fjpolo/UBC41ClassATubeAudioAmplifier/02 Imagenes/862703_4882853162860_1703502608_n.jpg

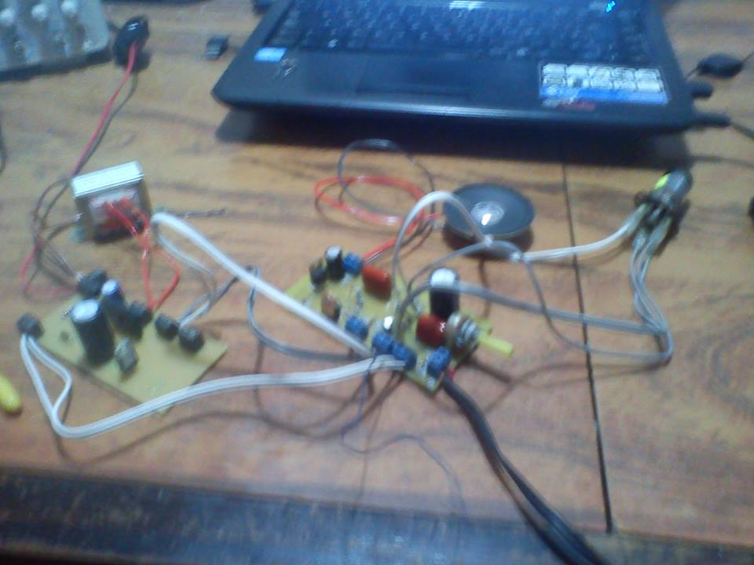
02 Imagenes/862703_4882853162860_1703502608_n.jpg
