fjpolo/UBC41ClassATubeAudioAmplifier/02 Imagenes/007 PCB.JPG

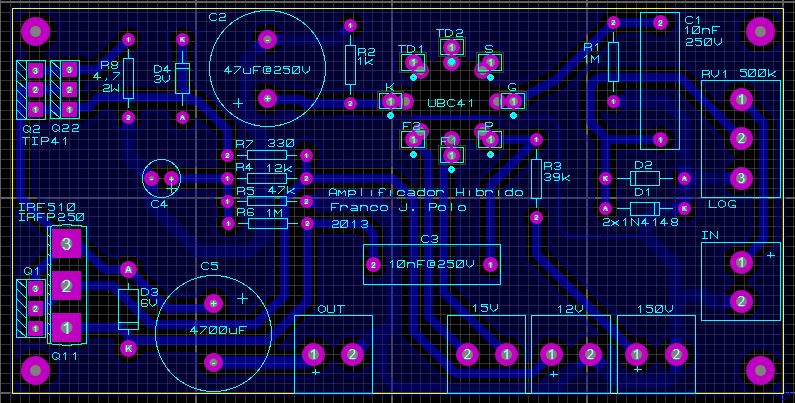
02 Imagenes/007 PCB.JPG
