fjpolo/UBC41ClassATubeAudioAmplifier/README.md

# UBC41ClassATubeAudioAmplifier
A hybrid Class A audio amplifier using an old RF UBC41.
