fjpolo/UBC41ClassATubeAudioAmplifier/005 PCB/Final.docx

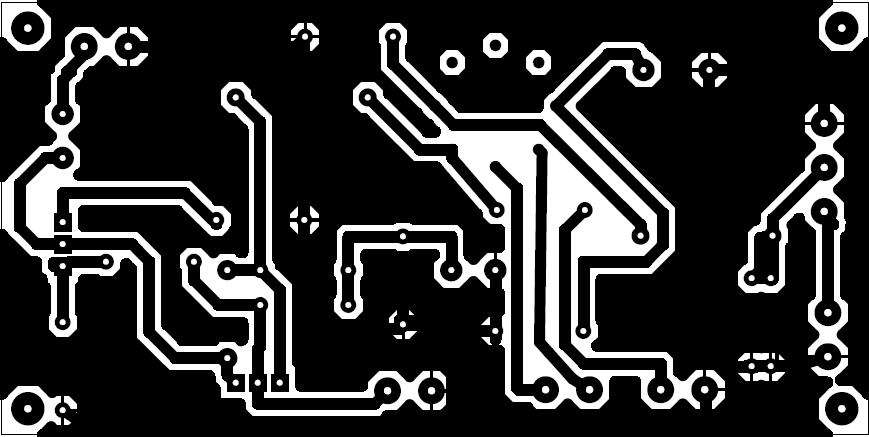
[picture p43: figure]
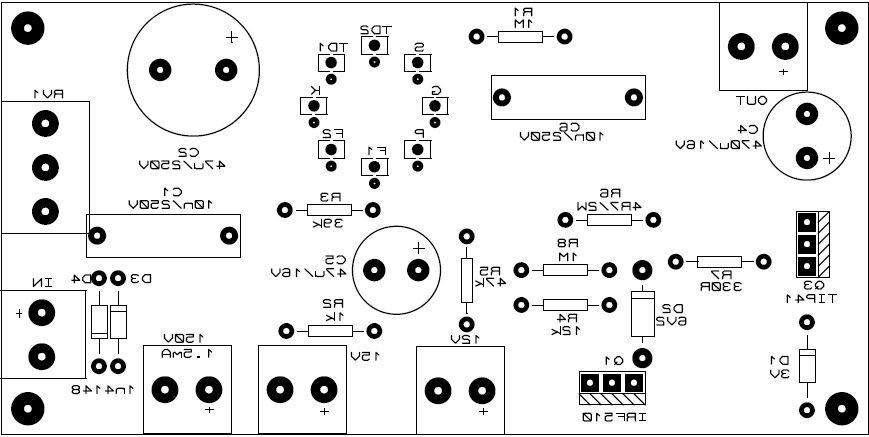
[picture p44: figure]
