fjpolo/UBC41ClassATubeAudioAmplifier/02 Imagenes/001 Schematic.JPG

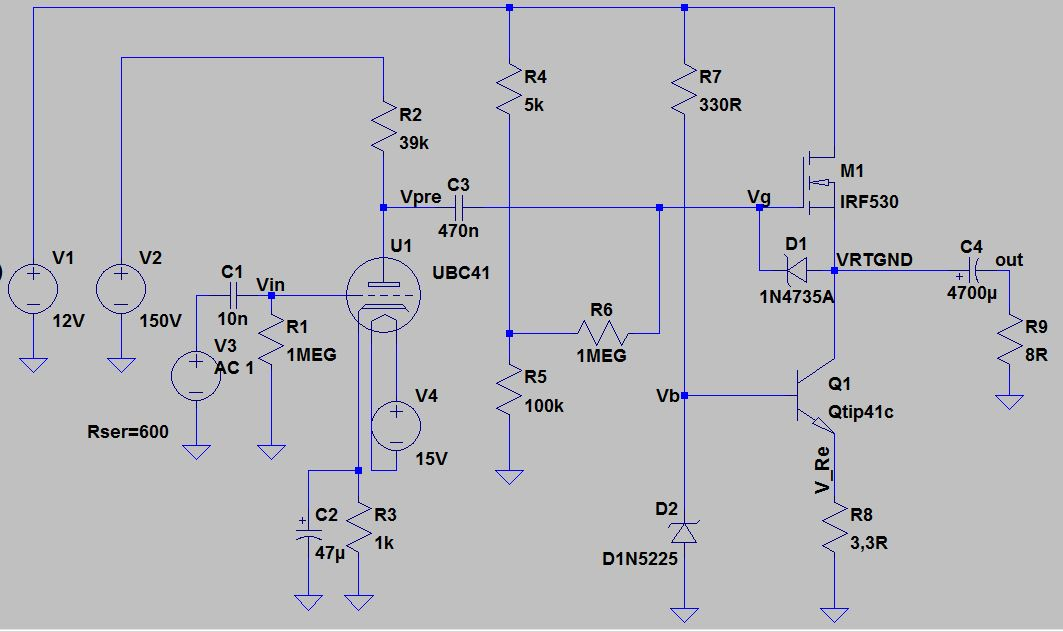
02 Imagenes/001 Schematic.JPG
