fjpolo/UBC41ClassATubeAudioAmplifier/02 Imagenes/001 Schematicv2.jpg

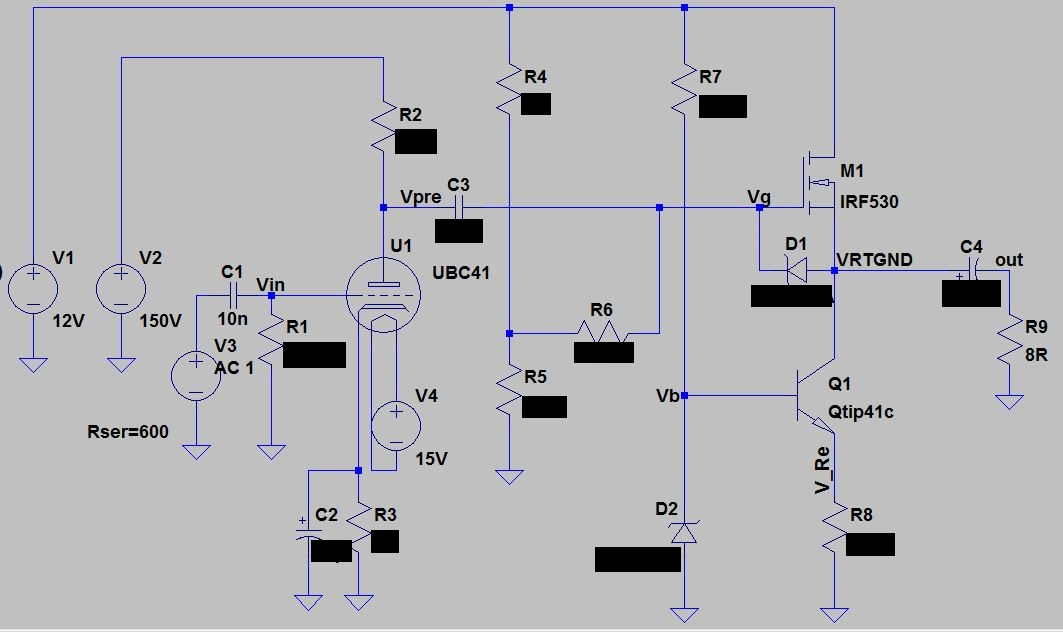
02 Imagenes/001 Schematicv2.jpg
