fjpolo/UBC41ClassATubeAudioAmplifier/02 Imagenes/003 TimeResponse.JPG

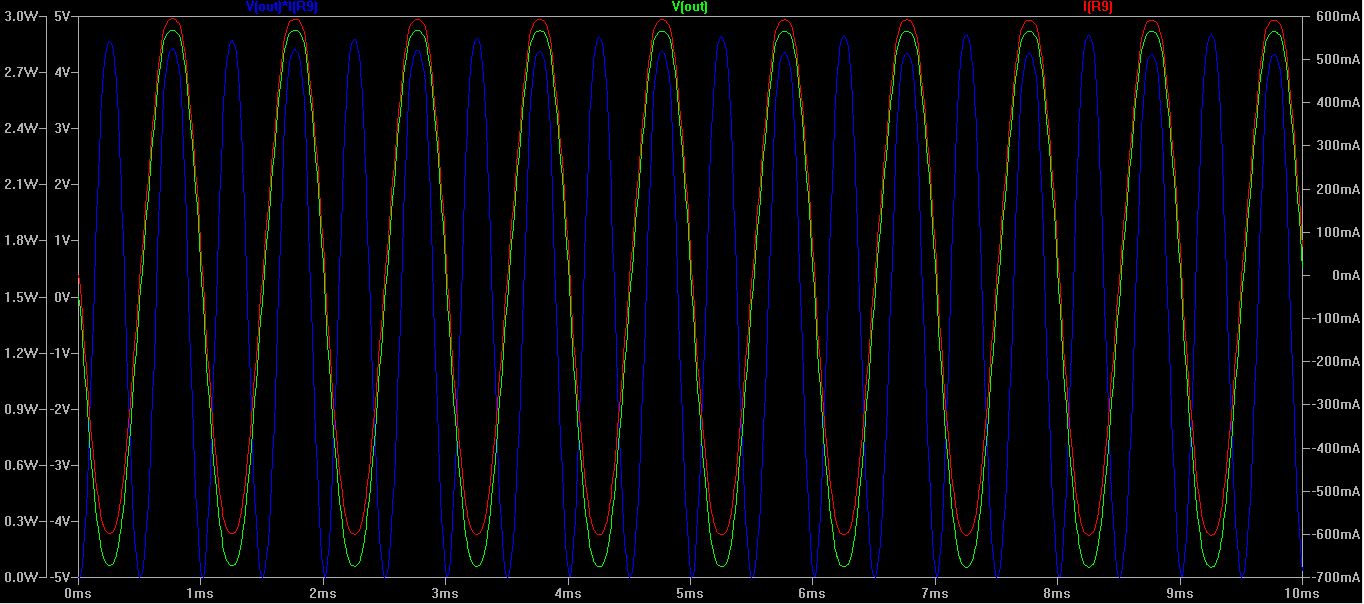
02 Imagenes/003 TimeResponse.JPG
