fjpolo/UBC41ClassATubeAudioAmplifier/02 Imagenes/006 THD.JPG

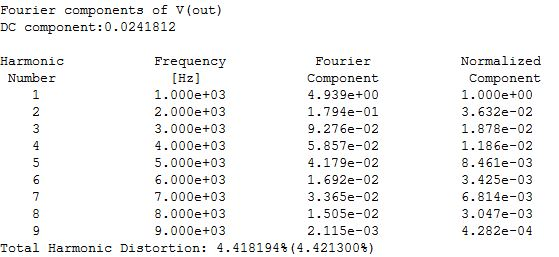
02 Imagenes/006 THD.JPG
