fjpolo/UBC41ClassATubeAudioAmplifier/02 Imagenes/UBC41 2.png

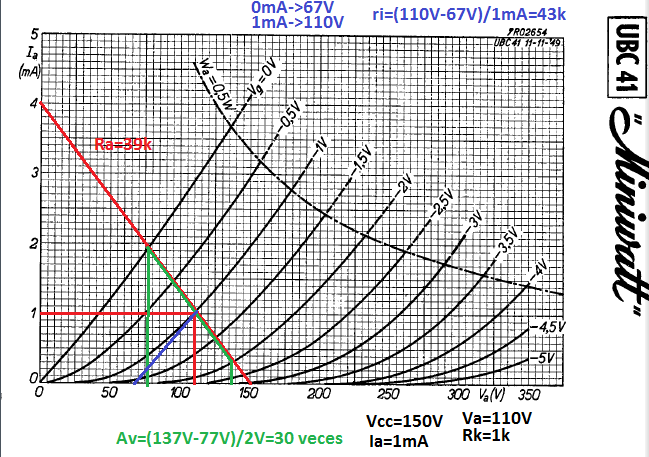
02 Imagenes/UBC41 2.png
