fjpolo/UBC41ClassATubeAudioAmplifier/005 PCB/ARES Professional - C__Users_SKA_Dropbox_Valvulas_Gaby_Finalsilk.pdf

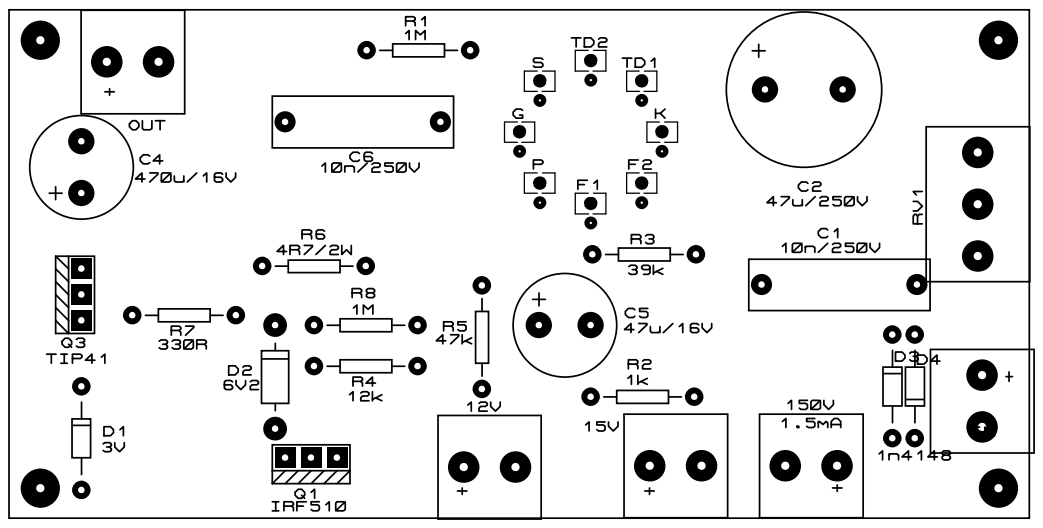
[picture p50: page 1]
