fjpolo/UBC41ClassATubeAudioAmplifier/005 PCB/Final.pdf

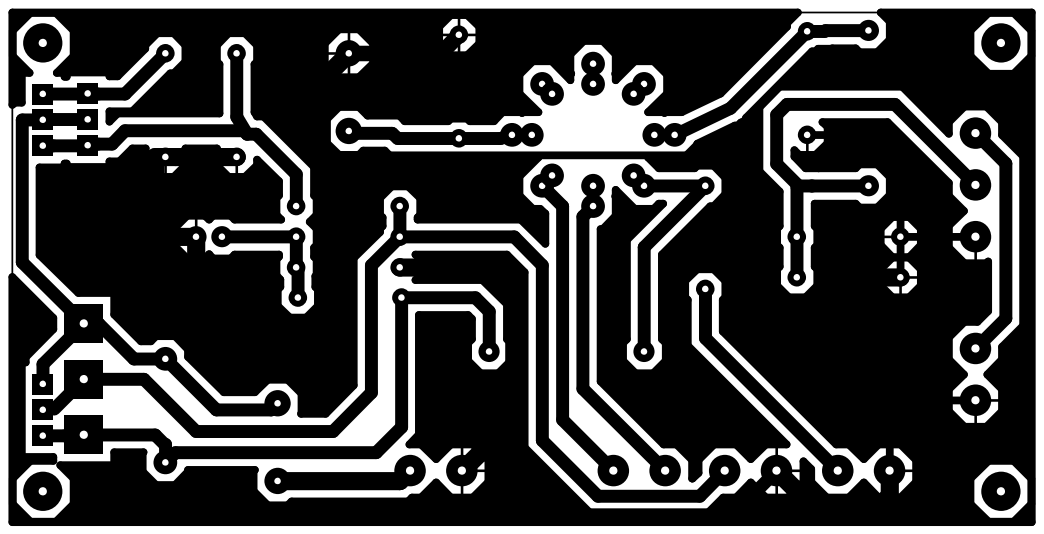
[picture p51: page 1]
