fjpolo/UBC41ClassATubeAudioAmplifier/005 PCB/FinalSilk.pdf

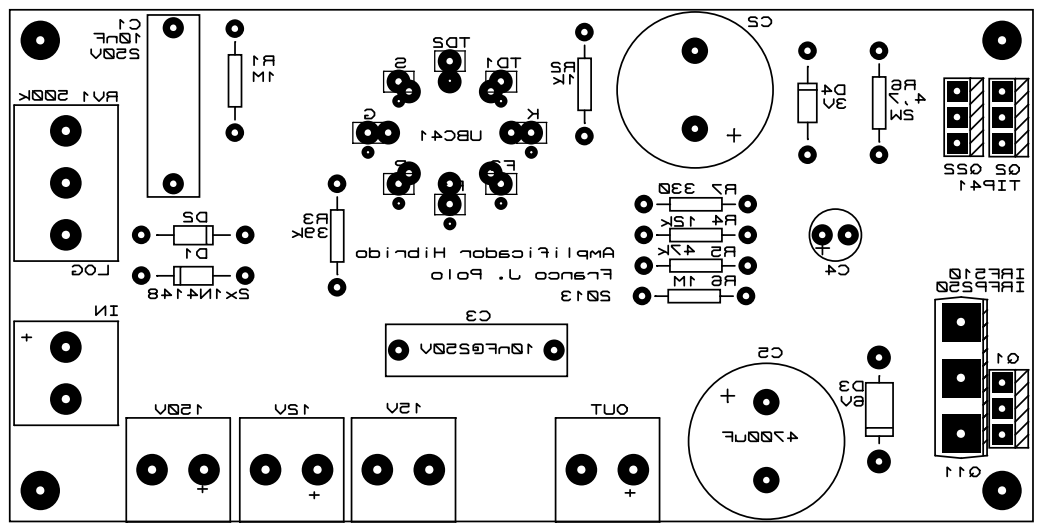
[picture p52: page 1]
