fjpolo/UBC41ClassATubeAudioAmplifier/005 PCB/Fuente.pdf

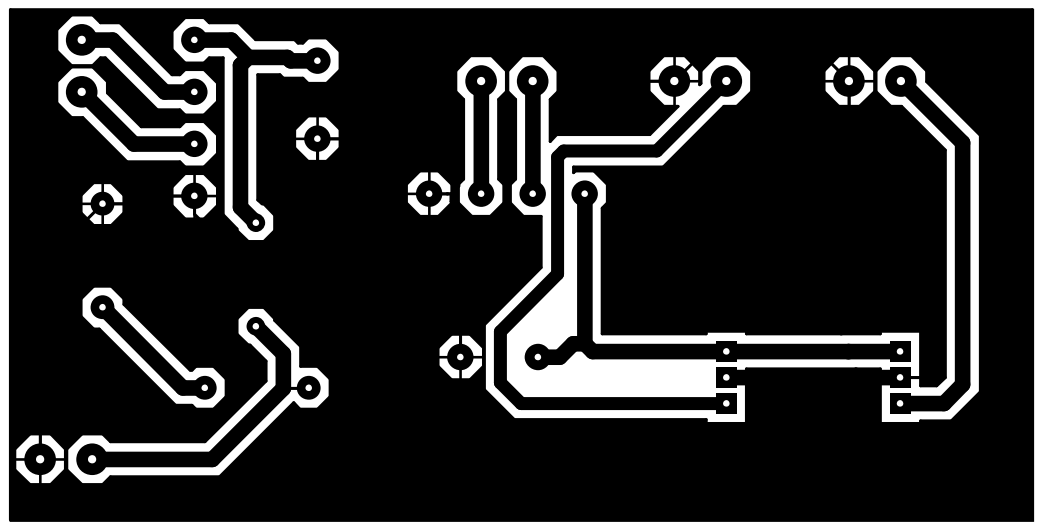
[picture p53: page 1]
