fjpolo/UBC41ClassATubeAudioAmplifier/01 Hibrido/Hibridov3.asc

C1: cap; 10n
C2: polcap; 47µ
C3: cap; 470n
C4: polcap; 4700µ
D1: zener; 1N4735A
D2: zener; D1N5225
M1: nmos; IRF530
Q1: npn; Qtip41c
R1: res; 1MEG
R2: res; 39k
R3: res; 1k
R4: res; 5k
R5: res; 100k
R6: res; 1MEG
R7: res; 330R
R8: res; 3,3R
R9: res; 8R
U1: triodeh; UBC41
V1: voltage; 12V
V2: voltage; 150V
V3: voltage; SINE(0 180m 1k); Rser=600
V4: voltage; 15V
Named nets: 0, out, VRTGND, Vg, Vb, V_Re, Vin, Vpre
.inc dmtriodep.inc
.inc TIP41.inc
.inc MoreDiodes.inc
.inc MoreZeners.inc
;FOURIER 1k v(out)
.FOURIER 20k v(out)
.tran 10m
;FOURIER 1k v(Vpre)
.FOURIER 20k v(Vpre)
