fjpolo/UBC41ClassATubeAudioAmplifier/(list of files, drawings)

Other design files:
004 PCB Proteus/Completoo.DSN
004 PCB Proteus/corriente.DSN
004 PCB Proteus/drenadorcomun.DSN
004 PCB Proteus/Final2.DSN
004 PCB Proteus/Final2.LYT
004 PCB Proteus/Final.DSN
004 PCB Proteus/Final.LYT
004 PCB Proteus/Fuente.DSN
004 PCB Proteus/Fuentefinal.DSN
004 PCB Proteus/Fuentefinal.LYT
004 PCB Proteus/hibrido.DSN
004 PCB Proteus/hibridofinal.DSN
004 PCB Proteus/Mosfet power follower2.DSN
004 PCB Proteus/Mosfet power follower.DSN
004 PCB Proteus/Polarizacion.DSN
004 PCB Proteus/salida.DSN
004 PCB Proteus/salidasch.DSN
004 PCB Proteus/salidasch.LYT
004 PCB Proteus/trafo.DSN
004 PCB Proteus/trafo.LYT
